ojoojoo/Simple-FPV-Cockpit-Display-S3/(commit log)

2026-11-07 ESP32-S3 / ILI9341 SPI port of Simple-FPV-Cockpit-Display
    A MAVLink artificial horizon for ArduPilot planes, ported from the
    original T-Display-S3 project by Keith Luneau to a plain ESP32-S3
    driving a 2.8" ILI9341 SPI panel.
    Changes from the original:
    - Hand-written LovyanGFX config for ILI9341 over SPI, replacing the
    LilyGo board profile, which drives an 8-bit parallel panel
    - B612, the Airbus/ENAC cockpit typeface, bundled as generated GFX
    font headers under the SIL Open Font License
    - One-line metric / imperial / aviation unit switch
    - Attitude smoothing with a soft deadband to stop gyro noise making
    the horizon shimmer
    - Forward prediction using the angular rates in ATTITUDE, canc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
    [Cockpit_Display_S3.ino]
2026-11-08 Add an optional WiFi MAVLink bridge for Mission Planner
    The board now forwards raw MAVLink both ways between the flight
    controller's serial port and a UDP socket, so a ground station can
    connect over WiFi while the cockpit display carries on unaffected.
    Bytes are passed through untouched, so MAVLink 2, signing and any
    dialect all work.
    Needs one extra wire: GPIO 43 (TX) to the flight controller's
    telemetry RX. Without it telemetry still flows, but Mission Planner
    cannot request parameters or command the aircraft.
    AP mode by default, so no router is needed in the field; BRIDGE_STA
    joins an existing network instead. UDP on 14550, the port Mission
    Planner offers. Telemetry is broadcast until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
